AhmeBahaa/Smart-Bionic-Arm-multi-sensor-fusion/Docs/presentationbionic (23-4-2026).pdf

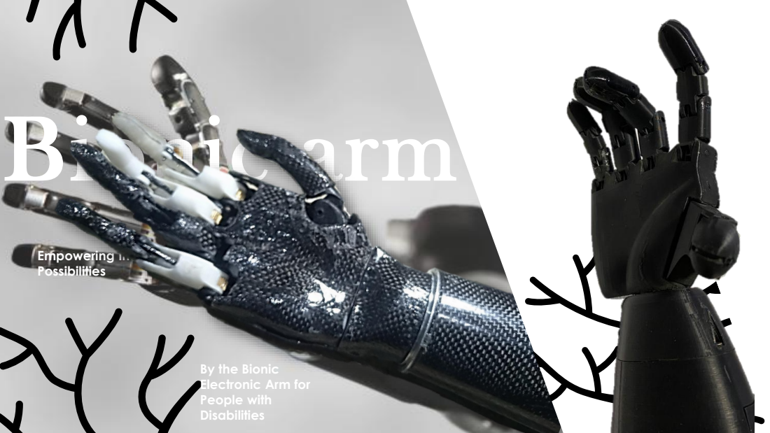
[picture p1: page 1]
Bionic arm

Empowering Individuals with Limitless
Possibilities

By the Bionic
Electronic Arm for
People with
Disabilities

# Problem

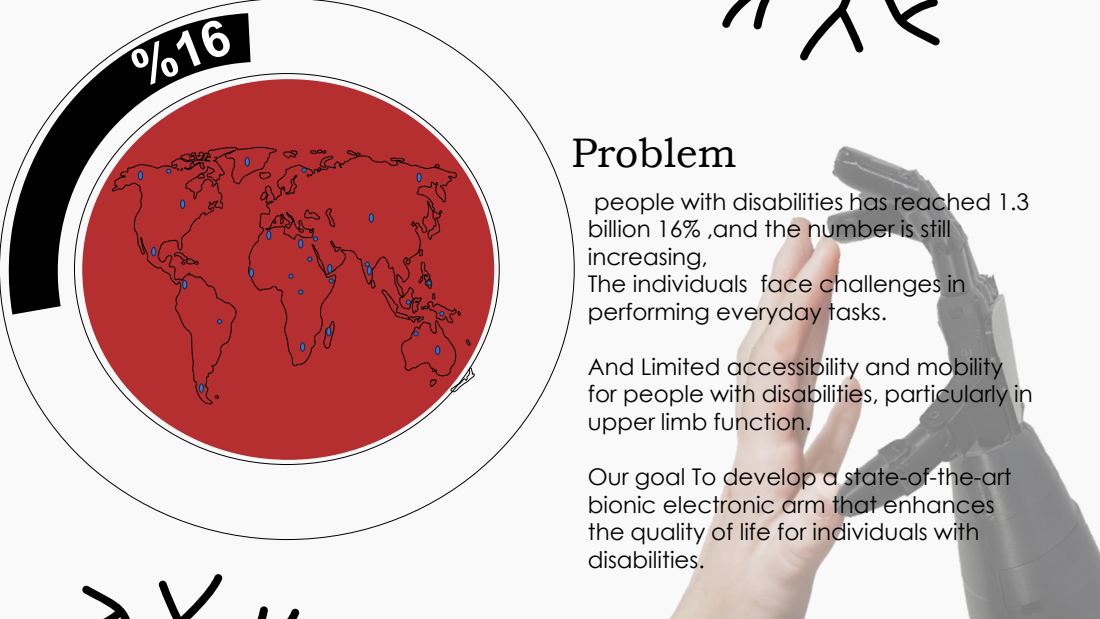
[picture p2: page 2]

people with disabilities has reached 1.3
billion 16% ,and the number is still
increasing,
The individuals face challenges in
performing everyday tasks.

And Limited accessibility and mobility
for people with disabilities, particularly in
upper limb function.

Our goal To develop a state-of-the-art
bionic electronic arm that enhances
the quality of life for individuals with
disabilities.

# BIONIC ARM B

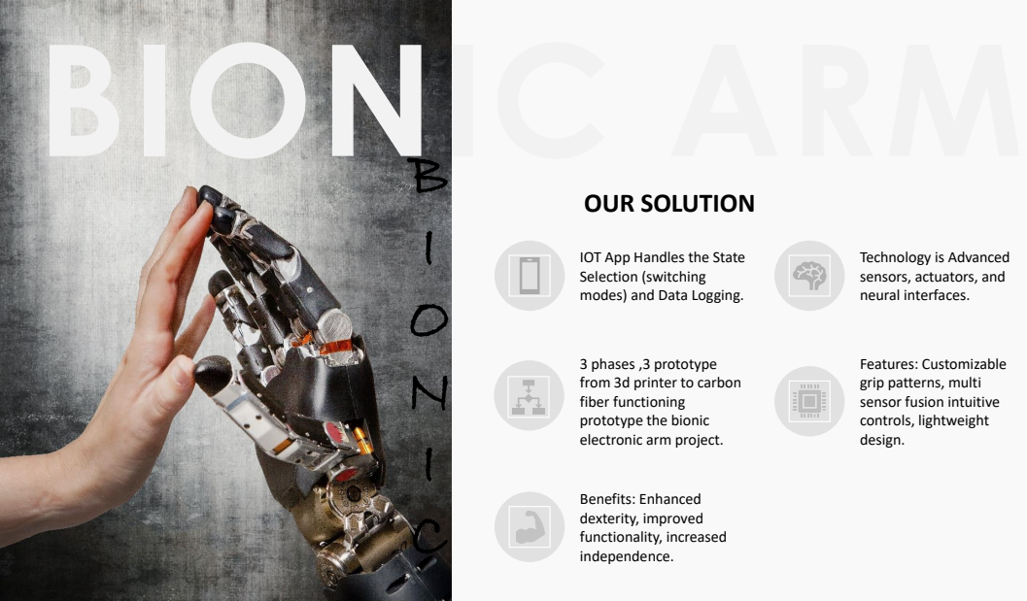
[picture p3: page 3]
Benefits: Enhanced dexterity, improved functionality, increased independence.; OUR SOLUTION

IOT App Handles the State
Selection (switching
modes) and Data Logging.

Technology is Advanced
sensors, actuators, and
neural interfaces.

3 phases ,3 prototype
from 3d printer to carbon
fiber functioning
prototype the bionic
electronic arm project.

Features: Customizable
grip patterns, multi
sensor fusion intuitive
controls, lightweight
design.

3

# rd functional

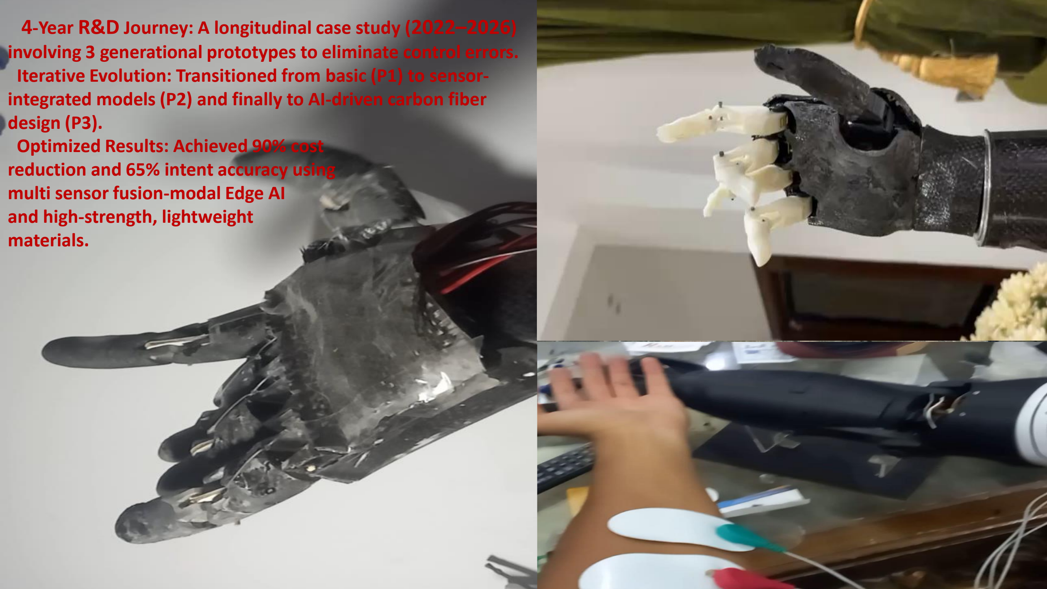
[picture p4: page 4]

# Interesting facts:

# prototype carbon fiber

1

# st ABS 3d printed model

2

nd model | o u r p r o t o t y p e

4-Year R&D Journey: A longitudinal case study (2022–2026) involving 3 generational prototypes to eliminate control errors. Iterative Evolution: Transitioned from basic (P1) to sensorintegrated models (P2) and finally to AI-driven carbon fiber design (P3).
Optimized Results: Achieved 90% cost
reduction and 65% intent accuracy using
multi sensor fusion-modal Edge AI
and high-strength, lightweight materials.

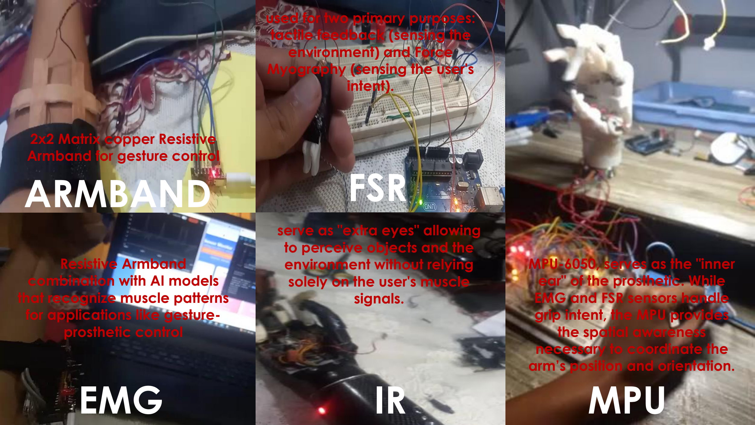
[picture p5: page 5]

# EMG

# FSR

IR | MPU

Resistive Armband
combination with AI models that recognize muscle patterns for applications like gestureprosthetic control

used for two primary purposes: tactile feedback (sensing the environment) and Force
Myography (sensing the user's intent).

serve as "extra eyes" allowing to perceive objects and the environment without relying solely on the user's muscle signals.

MPU-6050, serves as the "inner ear" of the prosthetic. While EMG and FSR sensors handle grip intent, the MPU provides the spatial awareness
necessary to coordinate the arm’s position and orientation.

# ARMBAND

2x2 Matrix copper Resistive Armband for gesture control

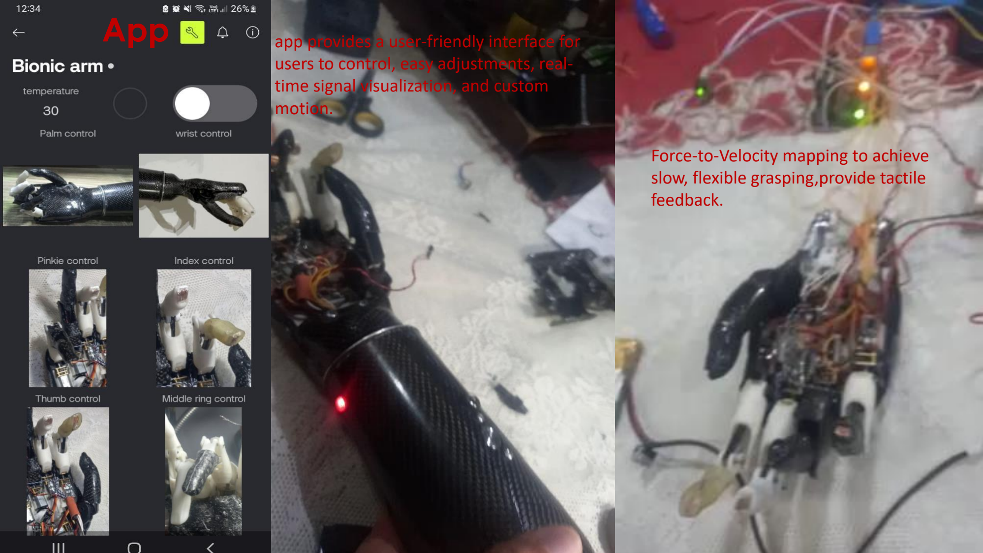
[picture p6: page 6]

# Interesting facts:

App | app provides a user-friendly interface for
| users to control, easy adjustments, real- time signal visualization, and custom motion.

Force-to-Velocity mapping to achieve slow, flexible grasping,provide tactile feedback.

# Weight about 350g

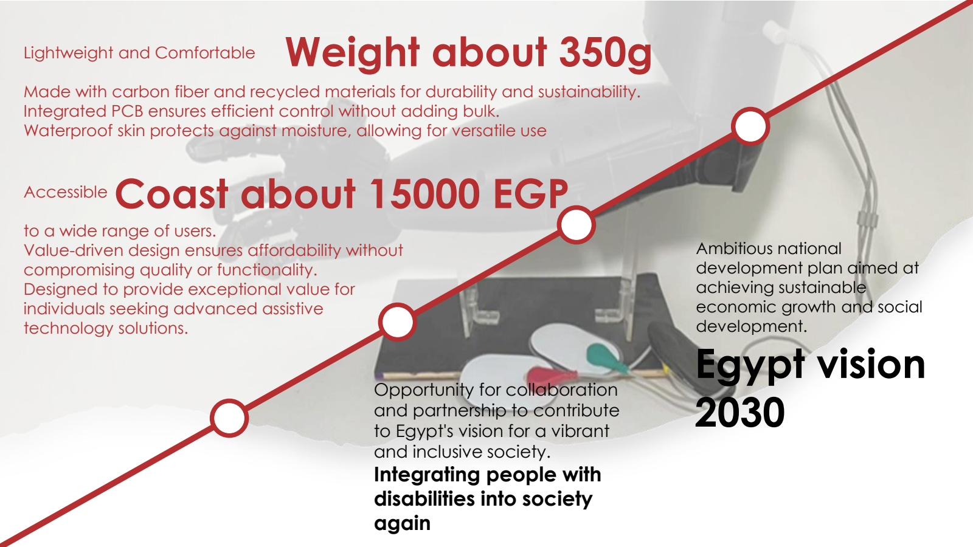
[picture p7: page 7]

# Coast about 15000 EGP

# Egypt vision

2030

### Integrating people with disabilities into society again

Opportunity for collaboration and partnership to contribute to Egypt's vision for a vibrant and inclusive society.

Ambitious national
development plan aimed at
achieving sustainable
economic growth and social development.

Accessible

to a wide range of users.
Value-driven design ensures affordability without compromising quality or functionality.
Designed to provide exceptional value for individuals seeking advanced assistive technology solutions.

Lightweight and Comfortable

Made with carbon fiber and recycled materials for durability and sustainability. Integrated PCB ensures efficient control without adding bulk.
Waterproof skin protects against moisture, allowing for versatile use

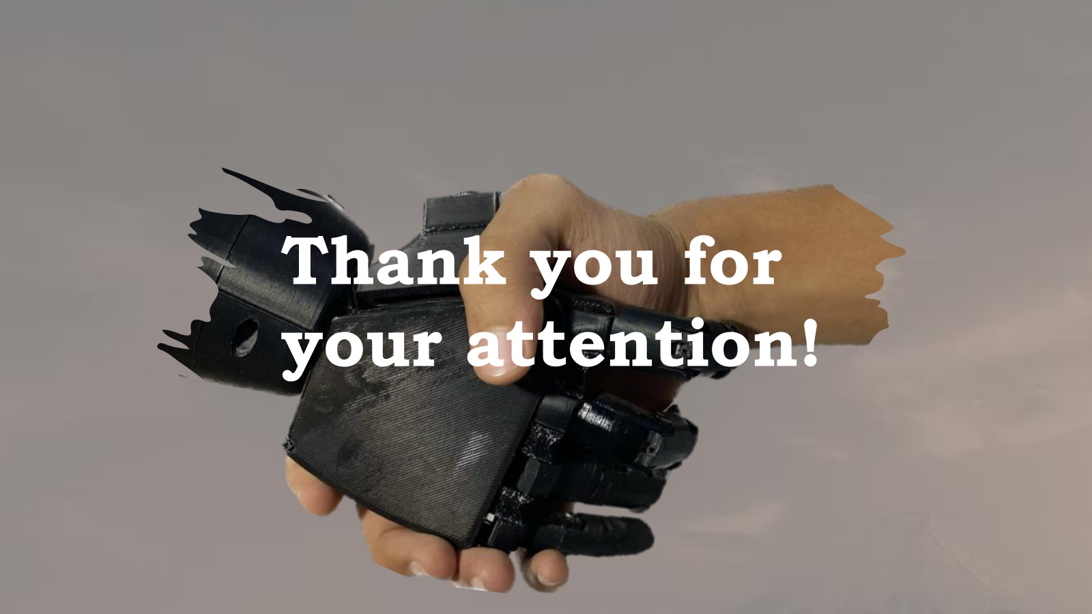
[picture p8: page 8]

# Thank you for your attention!
