AhmeBahaa/Smart-Bionic-Arm-multi-sensor-fusion/Docs/Research not published yet in MJEER-ahmedbahaaproject(10-7-2026 ).pdf

Research not published yet

# Design and Implementation of a Low-cost Carbon Fiber Bionic Arm with Multi-modal Sensor Fusion and IoT-Enabled Adaptive Control

Ahmed Bahaa El-Din, Saad Elsayed Saad

Abstract—Contemporary | prosthetic | arms | are | often
constrained by non-intuitive control mechanisms, excessive weight, and high cost. This paper presents the design and implementation of a low-cost, biomechatronic prosthetic arm utilizing a lightweight carbon fiber frame to achieve a 40% weight reduction (350g) compared to traditional 3D-printed frameworks. To overcome the high noise floor inherent in custom-built surface electromyography (EMG) sensors, a hybrid multimodal sensor fusion framework is introduced. The system implements a deterministic gating logic where a digital moving average filtered EMG signal acts strictly as an asynchronous activation trigger, while an armband pressure matrix tracks muscle expansion to determine specific grasp intents. An ESP32 microcontroller processes the sensory data locally, driving seven independent micro-actuators via an adaptive proportionalintegral-derivative (PID) control loop to ensure smooth, natural object manipulation. An IoT framework enables remote monitoring and clinician-led data logging. The prototype successfully delivers responsive, low-latency actuation under 500ms at an approximate cost of $310 USD.

Keywords— Myoelectric control, Prosthetic manipulation, Multimodal sensing, Embedded rehabilitation systems, Human– machine interface, Assistive robotics.

I. INTRODUCTION
THE Upper limb loss carries profound consequences for independence, since the hand underpins nearly every activity of daily living, and traumatic amputation remains its leading driver. Conventional body-powered and cosmetic prostheses often fail to restore functional dexterity, intuitive control, or meaningful feedback, with studies reporting abandonment rates of 26% for body-powered and 23% for electric devices [4]. While surface electromyography (sEMG) combined with pattern recognition has matured, persistent gaps—such as unintuitive control mappings and fragility under real-world variability—continue to keep most of these advances confined to the laboratory [1], [2], [3].

____________________________________________________________ (Corresponding author: Ahmed Bahaa El-Din).
Ahmed Bahaa El-Din is with the Department of Electronics and Communication Engineering, Higher Institute of Engineering and Technology Al-Obour , PO Box 27, Al Obour City Egypt (e-mail: 221399@oi.edu.eg). Saad Elsayed Saad is with the Department of Electronics and Communication Engineering, Higher Institute of Engineering and Technology Al-Obour, PO Box 27. He is now with the Department of Engineering and Technology, Obour University For Science & Technology, Al-Obour, (e-mail: saad.elsayed@oust.edu.eg(.

Beyond these technical hurdles, the global need for accessible assistive technology is staggering. With over 2.5 billion people requiring at least one assistive product, the World Health Organization and UNICEF (2022) report that access remains severely limited in low- and middle-income countries, with some regions seeing access rates as low as 3% [5]. This trend is mirrored locally in Egypt, where data from the Central Agency for Public Mobilization and Statistics (CAPMAS) indicates a disability prevalence of approximately 11% [6]. These figures underscore a critical socioeconomic gap in the availability of affordable, high-quality, and accessible biomedical solutions.
Addressing these shortfalls requires a convergent design that fuses heterogeneous biosignal and environmental sensing, lightens the mechanical load through composite materials such as carbon-fiber-reinforced laminates, and embeds the device inside a wider IoT service ecosystem for monitoring, recalibration, and personalization [7], [8], [9]. The mechanical architecture of the proposed hand builds upon the open-source compliant prosthetic design of Akhtar et al. [10], originally fabricated from PLA and silicone, extending it through carbon fiber composite construction, wrist rotation via a stepper motor, a six-axis sensor fusion framework (EMG, IMU, IR, FSR, Velostat armband, and temperature), empirical EMG threshold calibration, and an IoT framework comprising a mobile application and clinical web portal. This paper presents a multisensory-controlled bionic upper-limb prosthesis that integrates an accelerometer, infrared sensor, electromyography channel with an AI-driven feature-extraction and classification layer, distributed force-sensitive resistors (including an armband coupled to the EMG electrodes), and temperature sensing within a carbon-fiber, stainless-steel, and polymer hybrid chassis actuated by six DC metal-geared motors and one mini stepper motor for wrist articulation. Intelligence here is confined deliberately to EMG interpretation rather than endto-end autonomous decision making, while a dedicated Internet-of-Things layer—accessible through a mobile application and an accompanying web platform—provides remote monitoring, on-the-fly tuning, news dissemination, and a customization channel for users to commission prostheses fitted to their individual clinical, occupational, and aesthetic needs. By unifying multimodal sensing, robust composite construction, and connected service infrastructure within one platform, the proposed system targets the persistent gap between laboratory-grade myoelectric research and the everyday usability demanded by amputees [9].

II. MATERIALS AND METHODS

A. Mechanical Structure and Material Fabrication The forearm shell, palm plate, and dorsal hand enclosure of the AB-Limb were custom-fabricated from a carbon-fiber-reinforced epoxy laminate, as shown in Fig. 1. Fabrication was executed via Vacuum-Assisted Resin Transfer Molding (VARTM), a process in which a flexible vacuum bag seals a single-sided rigid mold so that atmospheric pressure drives resin through a dry carbon-fiber preform, allowing tight control of the fiber-to-resin ratio and evacuation of internal micro-voids without requiring autoclave pressure [11].

Fig. 1. Final AB-Limb prototype showing the assembled carbon fiber bionic arm alongside raw carbon fiber composite sheets used in fabrication. The hand mold geometry was adapted from the open-source compliant prosthetic design of Akhtar et al. [10], which was originally developed for silicone casting. In this work, the same mold architecture was repurposed for VARTM carbon fiber lamination: woven carbon-fiber plies were dry-laid over each mold, sealed under vacuum bagging film, and infused with a room-temperature-curing epoxy system. The modular component geometries — including wrist shell, palm plate, finger base blocks, and forearm cylinder — were further refined using parametric OpenSCAD scripts to generate gear profiles and mold optimizations prior to casting, as shown in Fig. 2 and Fig. 3.

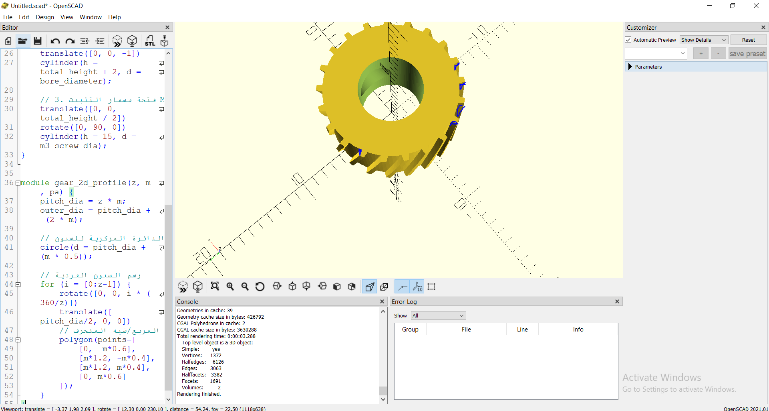
[picture p9: figure]

Fig. 2. Parametric computer-aided design and modular structural gears optimization using OpenSCAD environment.

The resulting composite structure achieved a tensile strength of approximately 600 MPa at a total structural mass of 350 g, representing a 40% weight reduction compared to equivalent aluminum or standard 3D-printed PLA frameworks [12], [13], [14]. This lightweight architecture reduces inertial resistance during movement, enhancing user mobility and reducing fatigue at the residual limb interface. A 1-Degree-of-Freedom wrist rotation unit driven by a miniature stepper motor was integrated along the forearm axis to provide pronation– supination capability absent from earlier single-anchor prosthetic frames [10].

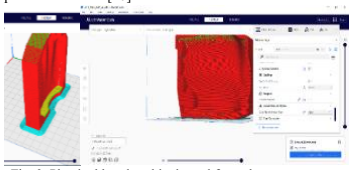
[picture p10: figure]

Fig. 3. Physical hand mold adapted from the open-source design of Akhtar et al. [10], originally developed for silicone casting and modified in this work for VARTM carbon fiber lamination.

B. Actuators and Hybrid Drive Integration Initial prototyping evaluated a direct-drive configuration in which six N20 DC micro-motors were driven through three L293D H-bridge chips cascaded via two cascaded 74HC595 8-bit shift registers were controlled by arduino uno [19],To manage these six channels while minimizing arduino GPIO consumption, as shown in Fig. 4. This architecture reduces the entire six-motor control bus of 4 pins for each motor to a three-wire serial interface — data, clock, and latch — from the microcontroller, electrically isolating the Arduino digital logic rail from inductive kickback during motor stalls .

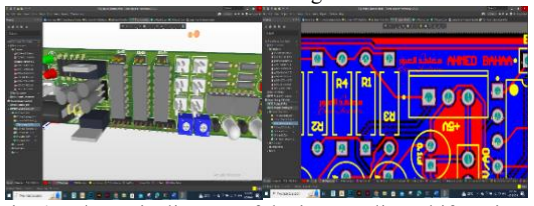
[picture p11: figure]

Fig. 4. Schematic diagram of the intermediate shift register topology interfaced with localized L293D motor drivers. While this arrangement confirmed mechanical feasibility, positional accuracy was insufficient for reliable grasp control and the GPIO demand — even after shift-register demultiplexing — constrained the available pins for the remaining sensor subsystems. These limitations motivated a redesign centered on the ESP32 and a hybrid actuation topology described below.
In the refined system, independent flexion and extension of the five fingers is achieved through six N20-series brushed DC micro-motors with high-ratio metal gearboxes.
Two motors actuate the thumb across two degrees of freedom, while the remaining four drive the index, middle, ring, and little fingers through linkages and custom epoxy-cast gears, as shown in Fig. 2 and Fig. 1.
A seventh channel drives the 1-DOF wrist rotation module via a 5V miniature stepper motor controlled through a ULN2003A driver board [15], [16].
Standard N20 units ship without integral closed-loop position feedback, which typically requires adding bulky optical or magnetic encoders to achieve controlled directional behavior

[16], [17]. To resolve this without inflating the device form factor, the internal control board of an SG90 micro-servo — including its feedback potentiometer and PWM conditioning circuit — was decoupled and integrated directly onto the N20 motor chassis, as illustrated in Fig. 5. The potentiometer is monitored continuously by the ESP32 PWM; when the wiper crosses a predefined directional threshold, a stop pulse is issued and the motor reverses, enabling reliable bidirectional control over each channel independently. This modification eliminates secondary encoders while reducing the per-motor control requirement to a single PWM line, allowing all six fingers to be addressed through only six control signals total.

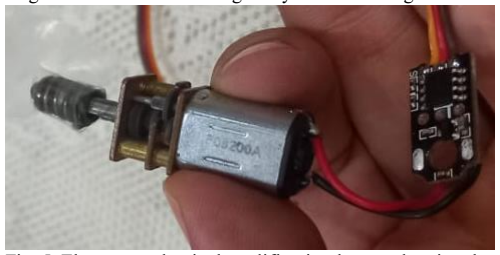
[picture p12: figure]

Fig. 5. Electro-mechanical modification layout showing the integration of decoupled SG90 servo control circuitry onto the N20 chassis.

the PWM commands are generated as hardware-timer pulses on the ESP32 for non-blocking real-time control, and are dynamically scaled by incoming force sensor and IR proximity readings through a local PID loop to suppress oscillation and overshoot during object approach [18].

C. Multi-Modal Sensor Integration and Signal Conditioning
1) Custom Surface Electromyography (EMG) System:
To maintain the cost-effective architecture of the AB-Limb, a custom single-channel active surface EMG (sEMG) acquisition front-end was developed (Fig. 6a), adapting the open-source OpenEMG hardware architecture developed by CharlesLabs as a structural baseline. The physical acquisition layout utilizes two Ag/AgCl surface electrodes with a 2 cm inter-electrode pitch positioned over the belly of the target residual-limb muscle group. A third reference electrode is placed on a nearby bony prominence to suppress common-mode environmental noise.
The differential biopotential is initially fed into a three-opamp instrumentation amplifier front-end built around an LM324 quad operational amplifier (Fig. 6b). This configuration provides a high input impedance (>10 MΩ) to prevent skin-electrode loading artifacts while maximizing the

Common-Mode Rejection Ratio (CMRR) to suppress powerline pickup and motion-induced baseline drift.
To enhance signal conditioning beyond the baseline open-source design, a secondary custom active filtering stage was integrated immediately following the instrumentation amplifier. This stage, engineered utilizing an LM358 dual operational amplifier, implements an active bandpass filter restricting the passband strictly between 20 Hz and 450 Hz. This optimization isolates the canonical sEMG spectral envelope while effectively rejecting low-frequency motion artifacts and high-frequency electronic noise.
The conditioned analog signal is then sampled by the central microcontroller. In firmware, a digital notch filter (50/60 Hz) is executed as an additional guard against grid interference. Following full-wave rectification, the signal is processed via a digital moving-average filter—implemented as a sliding window accumulator over N consecutive ADC samples—to yield a stable, low-latency amplitude envelope suitable as an asynchronous deterministic trigger [1], [2], [3].

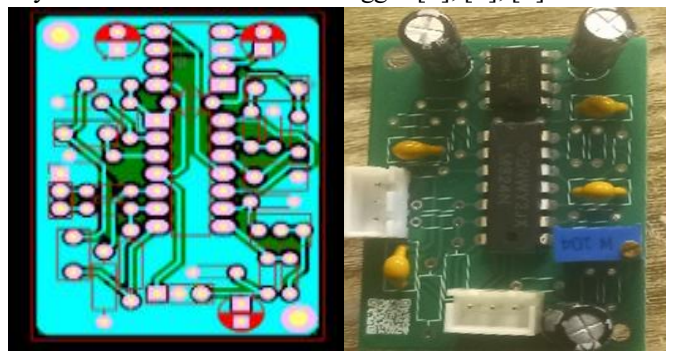
[picture p13: figure]

Fig. 6a. Custom-built active surface EMG sensor PCB layout.

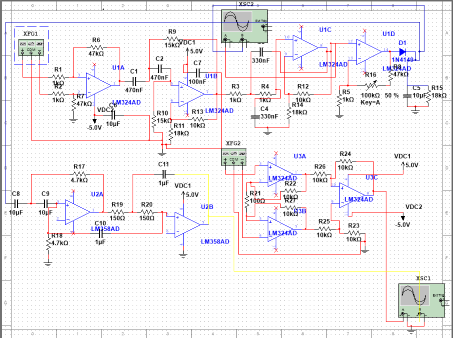
[picture p14: figure]

Fig. 6b. Custom-built active surface EMG sensor schematic hardware showing the LM324 instrumentation amplifier front-end and LM358 bandpass filtering stage.

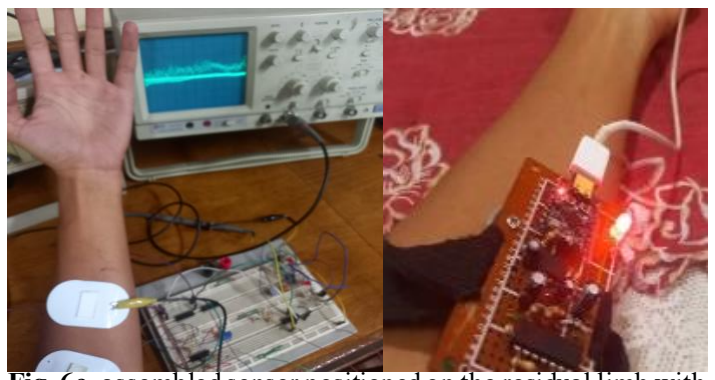
[picture p15: figure]

Fig. 6c. assembled sensor positioned on the residual limb with electrode connections,complete EMG acquisition unit integrated with ESP32-C3 controller for test.

Initial EMG data acquisition sessions revealed three critical calibration challenges that were systematically mitigated. First, a data-labeling anomaly occurred where a spurious third class label ('testing') was inadvertently introduced during token collection, degrading classifier performance to baseline chance level (~50%). This was resolved by filtering the training dataset to enforce strict binary classification (Contracted vs. Relaxed). Second, a structural class imbalance between contraction and relaxation samples was corrected using data resampling techniques to eliminate model bias toward the majority class. Third, an initial digital signal processing (DSP) misconfiguration utilized an improper high-pass filter setting that introduced phase distortion and attenuated critical low-frequency contraction envelopes while passing extraneous high-frequency electronic noise (Fig. 7). This was corrected by optimizing the digital filter coefficients to stabilize the baseline envelope and ensure robust intent recognition.

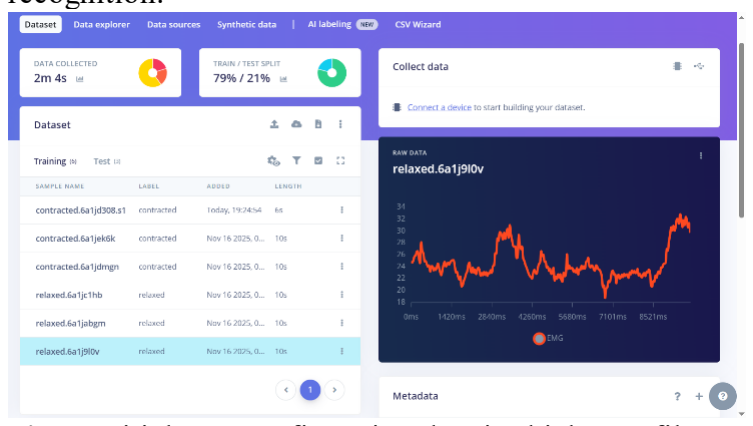
[picture p16: figure]

Fig. 7. Initial DSP configuration showing high-pass filter at 19 Hz cut-off — this setting passed high-frequency noise and produced an unstable filtered output, motivating the filter redesign.
These issues were resolved sequentially: the 'testing' samples were deleted from the dataset, recording sessions were repeated to achieve balanced class durations, and the filter was reconfigured to a low-pass type with a 50 Hz cut-off frequency and FFT length of 512, with StandardScaler normalization enabled. Following these corrections, model training over 30 epochs with a learning rate of 0.0005 achieved 100% classification accuracy with a final loss of 0.00 on both training and validation sets, as confirmed by

TensorBoard convergence curves Fig.8. Fig. 9. The INT8-quantized model deployed on the ESP32 demonstrated an inference latency of 1 ms, a peak RAM consumption of 2.4 KB, and a Flash footprint of 35.8 KB.

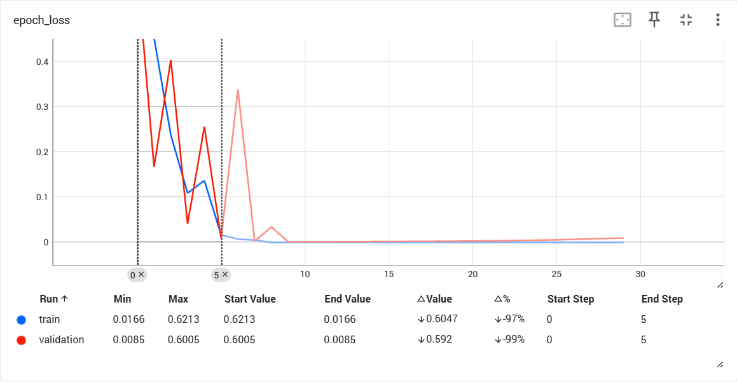
[picture p17: figure]

Fig. 8. TensorBoard epoch loss curves, prior to data cleansing, showing validation loss divergence and 50% accuracy indicative of overfitting.

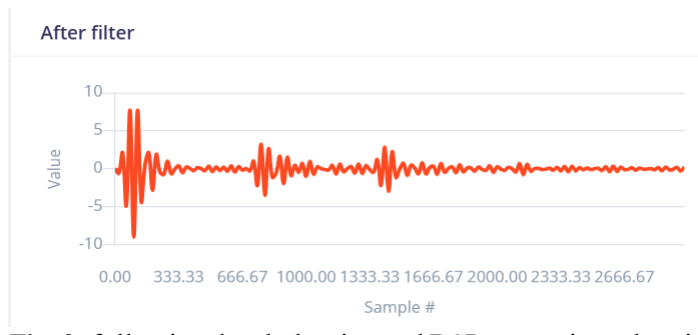
[picture p18: figure]

Fig. 9. following data balancing and DSP correction, showing co-convergence of training and validation loss to 0.00 within 10 epochs, confirming successful generalization.

Subject-specific activation thresholds were determined empirically using the Edge Impulse Studio platform as a signal visualization tool. Raw sEMG signals were captured under two controlled conditions — full voluntary muscle contraction and complete rest — and the resulting amplitude envelopes were inspected to extract the peak activation level and the quiescent baseline, as illustrated in Fig. 10. The activation threshold was iteratively refined through empirical calibration sessions: the subject performed repeated contraction and rest cycles while the threshold constant in firmware was manually adjusted until reliable, false-positive-free triggering was achieved for that individual's signal profile. These empirically determined bounds were encoded as fixed threshold constants in the ESP32 firmware, providing a patient-calibrated binary trigger that avoids the latency and computational overhead of real-time multi-class classifiers.

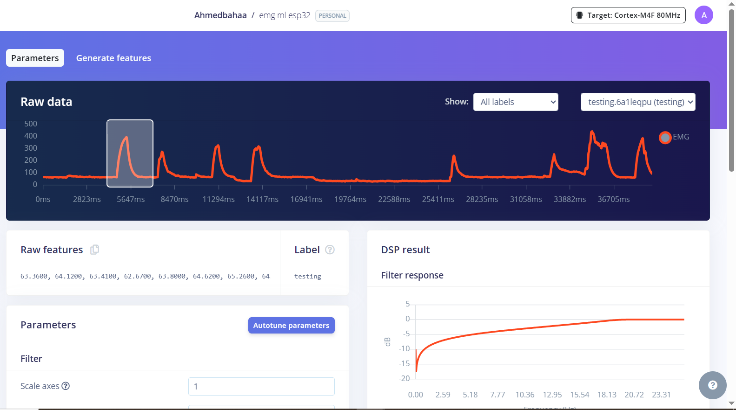
[picture p19: figure]

Fig. 10. Raw sEMG signal acquired via Edge Impulse Studio showing repeated voluntary contraction events (amplitude spikes reaching 0–450 ADC units) interspersed with quiescent rest periods, used to empirically determine the subject-specific activation threshold encoded in ESP32 firmware.
To suppress false-positive triggers arising from EMG drift or motion artifact, actuator activation requires simultaneous confirmation from the 2×2 Velostat armband matrix Fig. 11.

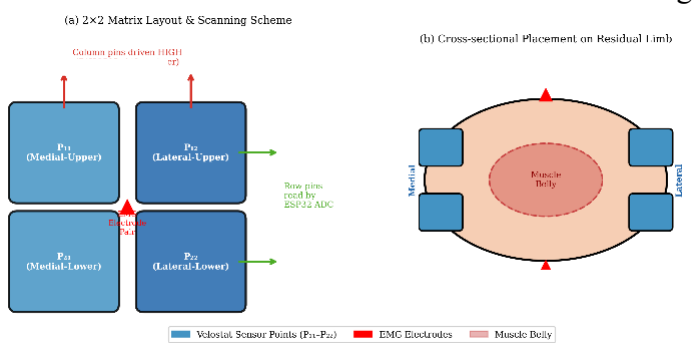
[picture p20: figure]

Fig. 11. Armband pressure matrix showing sensor placement medial and lateral to the primary EMG electrode pair over the muscle belly, and the pulse-scanning readout scheme implemented.

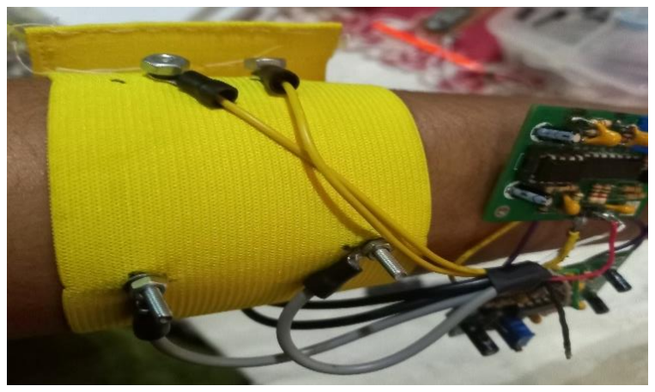
[picture p21: figure]

Fig. 12. layout of the armband and EMG electrode pair over the muscle belly.
the motor command is only issued when both the EMG threshold and at least one armband pressure point are crossed within the same sampling window, implementing a dual-verification logic gate in firmware [22], [23].The four armband sensing points are positioned at two anatomical landmarks: medial and lateral to the primary EMG electrode pair, directly over the muscle belly Fig. 12., so that voluntary contraction produces a consistent bilateral pressure signature.
2) Spatial Armband Pressure Matrix and Custom Force Sensors:
To resolve the false-positive triggering that arises from raw sEMG drift, the AB-Limb integrates a tactile sensing layer with two distinct physical roles: an internal intent validator and an external contact verifier [24]. The internal layer is a custom 2×2 armband pressure matrix fabricated from flexible Velostat sheet, a carbon-loaded polymeric foil whose resistance decreases under pressure, making it a low-cost piezoresistive transducer for wearable sensing [22], [25].

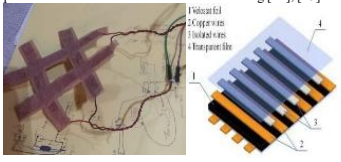
[picture p22: figure]

Fig. 13. Structural layout of the custom Velostat-based spatial armband pressure matrix.

Each column of the matrix was sequentially driven HIGH while the orthogonal rows were read by the ESP32 ADC, implementing a fast pulse-scanning readout that suppresses ghosting during simultaneous multi-point contact. The raw readings were smoothed with a first-order digital low-pass filter with α = 0.08 to yield a stable mechanical image of muscle bulging under voluntary contraction, providing an intent channel independent of the electrical noise floor that limits surface EMG [24], [25], [26].
For external contact verification, four custom force-sensing resistors measuring 6 mm × 6 mm were embedded into the distal phalanges of the prosthetic fingertips Fig. 14. each FSR was wired into a 10 kΩ pull-down voltage divider so that mechanical load maps linearly to an analog voltage readable by the ESP32 ADC [27], [28]. The force reading was passed through a Force-to-Velocity algorithm that progressively reduces drive PWM as grip force increases, preventing brittle objects from being crushed during pinch closure. A localized PWM-driven vibration motor against the user's skin was triggered on contact confirmation to close the sensory loop [29], [30].

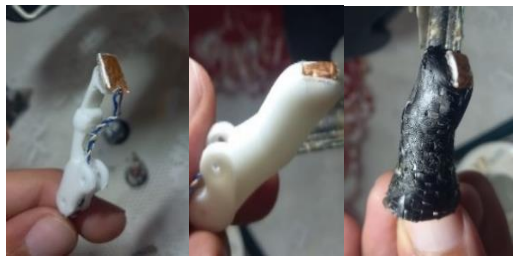
[picture p23: figure]

Fig. 14. Miniaturized 6mm x 6mm custom fingertip force sensor integration and voltage divider conditioning circuit.

3) Kinematic Motion Processing Unit (MPU):
An MPU6050 six-axis inertial measurement unit, combining a tri-axis accelerometer and a tri-axis gyroscope on a single chip, was embedded inside the dorsal hand enclosure to provide orientation-aware control that operates independently of, and complementary to, the sEMG channel [29], [31]. Raw angular data from the gyroscope was fused with accelerometer-derived gravity references through a complementary filter to obtain a stable tilt estimate along the wrist's principal bending axis Fig. 15. When gesture-control mode is selected through the mobile application, the residual-limb tilt is fed through the same PID regulator used for motor commutation: forward tilt drives uniform finger flexion, backward tilt drives uniform extension, and a dead-band around the level orientation locks the actuators in a steady-

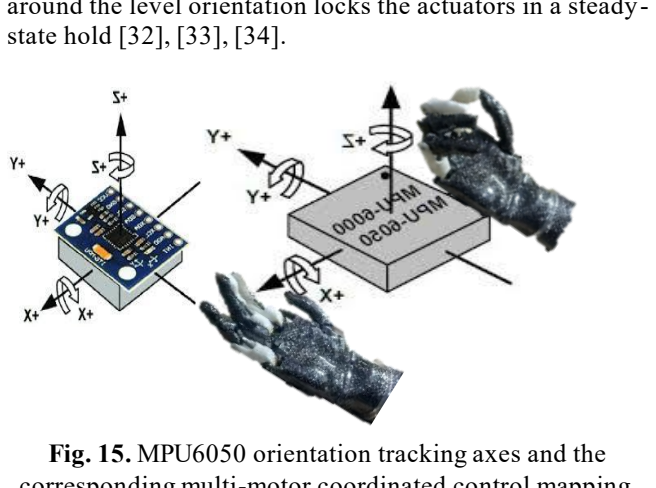
[picture p24: figure]
state hold [32], [33], [34].

Fig. 15. MPU6050 orientation tracking axes and the corresponding multi-motor coordinated control mapping.

4) Infrared (IR) Proximity and Collision Avoidance Gating:
A short-range infrared emitter-photodiode pair mounted on the palmar surface of the prosthesis continuously samples the distance between the terminal device and any approaching object. The photodiode output is conditioned by an LM358-based Fig. 16. comparator that yields a binary trigger as the object enters a pre-set safety envelope, and the smoothed analog channel is fed into the same PID loop that governs motor velocity so that approach speed is scaled inversely with distance, decelerating the actuators near object boundaries [29], [35], [27], [36]. This channel also acts as a hardwareinterrupt-driven reflexive layer: a rapid proximity transition during a hold-and-release state bypasses the main sEMG/IMU threads and fires an emergency close command that mimics a biological protective reflex [30], [37].

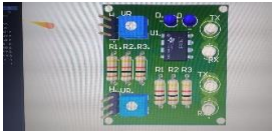
[picture p25: figure]

Fig. 16. PCB layout of the LM358-driven infrared proximity sensing circuit.

5) Thermal Monitoring Layer:
An NTC thermistor with β = 3950 was embedded at the residual-limb interface inside the socket wall, selected over non-contact infrared modules such as the MLX90614 because its small form factor and direct skin contact provide higher accuracy in the clinically relevant 35°C to 42°C range [38], [39], [40]. The thermistor was paired with a 10 kΩ balance resistor to form a voltage divider readable by the ESP32 ADC, and the nonlinear resistance-to-temperature relationship was linearized in firmware using the Steinhart–Hart equation:

where T is the absolute temperature in kelvin, R is the computed thermistor resistance, and A, B, and C are coefficients derived from the manufacturer datasheet (β = 3950). Because the ESP32's successive-approximation ADC exhibits nonlinearity near the 0 V and 3.3 V saturation margins, an oversampling and averaging routine of 10–20 samples per reading was executed to suppress transient electronic noise and stabilize the calibrated output [41], [42]. Thermal readings are streamed to the cloud IoT portal and trigger an alert if the residual-limb skin temperature exceeds the physiologically safe envelope, guarding against the insocket heat accumulation linked to skin irritation and prosthesis abandonment [43], [44].

D. | Control | System | Architecture, | IoT
Infrastructure, and Power Management
1) Central Controller and System Architecture: The core processing hub of the AB-Limb is an ESP32 DevKit microcontroller, chosen for its dual-core 240 MHz architecture, native Wi-Fi and Bluetooth Low Energy radios, and its demonstrated capacity to host real-time sEMG and sensor-fusion pipelines on a low-cost embedded platform [21], [45]. The firmware is organized as a state-triggered actuation engine: grip selection, sensor gating, and actuation windows are exposed as runtime-tunable parameters that the user can adjust through the mobile companion application rather than through low-level firmware reflash, allowing patients to adapt the prosthesis to changing daily-life activities without any code modification [46], [21].

1
T

= A + Bln(R) + C (ln(R))

3

(1)

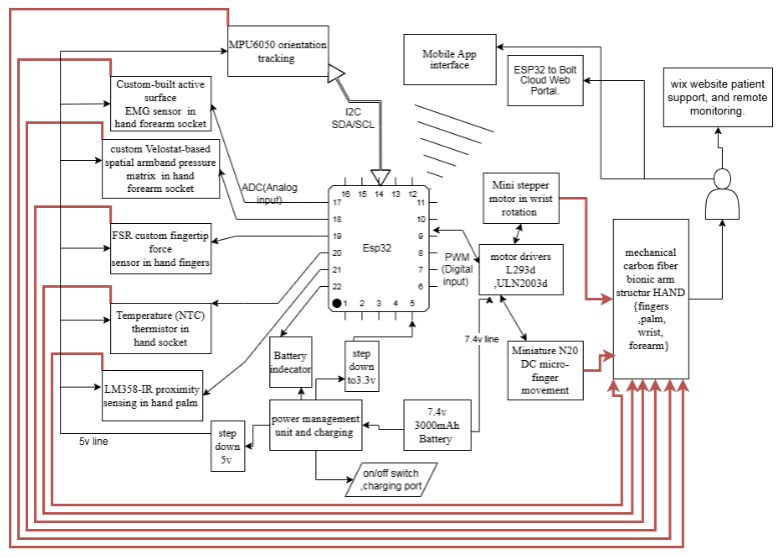
[picture p26: figure]

Fig. 16. System block diagram showing the ESP32 core architecture, multi-sensor interfacing layers, and peripheral distribution.

2) Cloud IoT Telemetry and Remote Clinical Portal:
Filtered sEMG envelopes, force-matrix readings, IMU orientation logs, and thermal samples are encrypted and transmitted over Wi-Fi to a centralized cloud portal built around the Bolt IoT framework, exposing WebSocket, MQTT, and HTTP endpoints that allow clinicians to asynchronously review biomechanical signal histories, track muscle-health progression, and adjust validation thresholds remotely [9], [46], [47], [48]. The same portal hosts a public news and updates channel and a customization intake form through which users can commission prostheses fitted to their individual clinical, occupational, and aesthetic requirements, closing the Industry 4.0 loop between physical actuation and digital service infrastructure [49].Fig. 17.

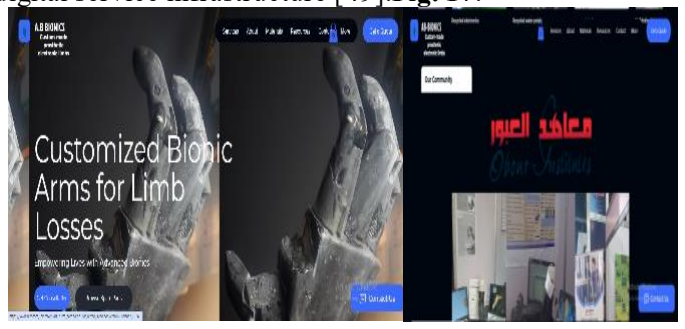
[picture p27: figure]

Fig. 17. Cloud IoT web portal interface showing real-time EMG signal monitoring dashboard, remote clinical threshold adjustment panel, and patient customization intake form.

3) Power Management System:
Mobile operation is sustained by a lightweight 7.4 V two-cell lithium-polymer battery pack with a high discharge C-rating sufficient to absorb the transient inrush currents drawn during simultaneous multi-motor grasping routines. A dual-stage synchronous buck DC-to-DC converter topology supplies a regulated 3.3 V rail for the ESP32 and sensor front-end and a separate high-current rail for the L293D motor drivers, isolating the noise-sensitive digital logic lines from the inductive voltage ripple and stall-current spikes of the brushed

DC actuators during peak load conditions [48], [21].
To extend operational battery life during periods of prosthetic inactivity, the ESP32's native Deep Sleep mode was implemented in firmware. In this state, all peripheral clocks, the Wi-Fi radio, and the main CPU cores are gated off,
reducing the | microcontroller's | current | draw | from
approximately 240 mA during active multi-sensor polling to under 10 μA. A configurable inactivity timer monitors the sEMG envelope and armband pressure channels; if no voluntary activation event is detected within a user-defined timeout window, the system autonomously transitions to Deep Sleep and resumes full operation upon the next muscle contraction trigger via the ULP co-processor wake-up interrupt. This adaptive duty-cycling strategy significantly reduces mean current consumption during daily prosthetic use, where active grasping intervals are interspersed with extended periods of limb rest [48].
Fig. 18.

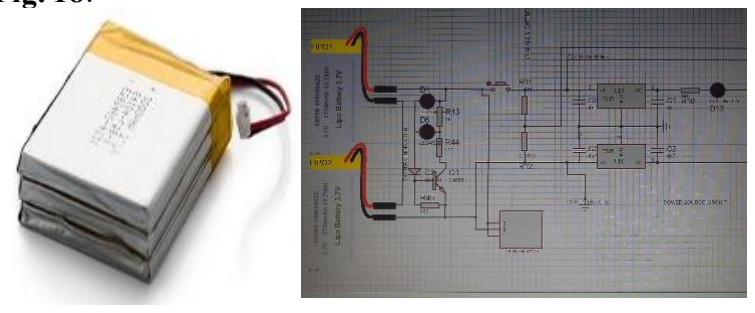
[picture p28: figure]

Fig. 18. Schematic of the power management unit showing the 7.4V LiPo source and dual-stage buck regulation paths for digital and motor power rails.
4) Software Architecture and Multi-Modal Control Topology:
The ESP32 firmware implements a layered multi-modal control pipeline in which four operating modes share a common actuation scheduler [46], [50]:
Mode 1 — Pure EMG Control: evaluates the rectified, smoothed sEMG amplitude directly and maps temporal intensity thresholds to discrete motor actions, providing a fallback channel when the other sensors are unavailable. Mode 2 — Proximity-Triggered IR and Force Regulation: uses the IR proximity channel to pre-shape the optimal grip profile before physical contact occurs, then hands over to the four fingertip FSRs (6 mm × 6 mm each) for compliant force modulation during contact [27], [36].
Mode 3 — Kinematic IMU Orientation Mapping: translates residual-limb tilt into grip configuration through gravity-compensated positioning — forward tilt drives uniform finger flexion, backward tilt drives extension, and a dead-band around level orientation locks the actuators — providing orientation awareness independent of EMG quality [31], [32]. Mode 4 — Asynchronous Sensor Fusion (Primary Mode): combines all channels through a deterministic gating logic in which the moving-average-filtered EMG envelope acts as an asynchronous activation trigger, the Velostat armband pressure matrix disambiguates grasp intent, the MPU6050 contributes kinematic shape selection, and the fingertip FSRs close the loop with a compliant termination command once a stable grip is established [29], [27], [36], [24]. This layered fusion architecture ensures modularity and facilitates rapid integration of emerging sensing modalities [51], [52], [53].

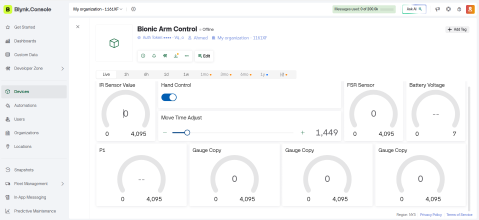
[picture p29: figure]

Fig. 19. Software ecosystem architecture illustrating the real-time data flow between the ESP32, Bolt Cloud library, and cloud web portal.

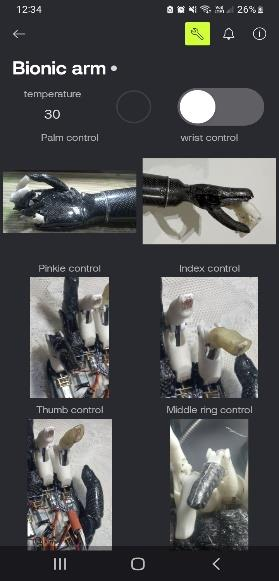
[picture p30: figure]

Fig. 20. Mobile application interface showing grip mode selection, real-time EMG threshold display, and sensor status panel.

III. RESULTS AND DISCUSSION Longitudinal Prototype Evolution Case Study (2022–2026) To achieve the optimized biomechatronic profile of the AB-Limb, a four-year longitudinal development case study was conducted across three distinct generational prototypes, benchmarking structural durability, weight reduction, and sensor reliability at each stage.
Prototype I (Conceptual Phase — 2022): Focused on basic multi-finger kinematics using a fully 3D-printed PLA frame with analog IR sensors. Testing revealed critical limitations in structural strength under load, high inertial mass, and significant electrical noise that precluded reliable EMG signal acquisition.

Prototype II (Sensory Integration Phase — 2024): Transitioned structural framing to reinforced polymers and aluminum alloys. Custom active surface EMG bio-amplifiers and commercial FSRs were introduced. Grip force control was successfully validated; however, structural mass remained high and raw EMG drift produced false-positive actuator triggering, motivating the dual-verification approach adopted in the final design.
Prototype III (Optimized Final Platform — 2026): The structural framework was fully transitioned to VARTMmolded carbon fiber-epoxy composite, integrating the 2×2 Velostat armband scanning matrix, MPU6050 orientation tracking, and autonomous reflex gating logic, as shown in Fig.
21. This iteration achieved a 40% reduction in structural weight relative to Prototype II and a production cost below $310 USD, representing over 90% reduction compared to premium commercial benchmarks.

Fig. 21. Generational evolution chart of the AB-Limb prototypes (2022–2026) mapping structural material transitions against sensor integration complexity.

B. System Actuation and Latency Performance End-to-end system latency — defined as the elapsed time from initial voluntary muscle contraction to completion of terminal device grasp execution — was assessed using repeated timed trials with a mobile stopwatch reference across multiple contraction-and-release cycles. The measured average deployment latency was 380 ms under normal operating conditions, which sits comfortably below the 500 ms perceptual threshold identified in the literature as the boundary for intuitive prosthetic responsiveness [54], [56].
The PID velocity control loop was evaluated by comparing motor transient behavior with and without active PID feedback during repetitive finger flexion cycles. Without PID correction, the N20 motors exhibited visible positional oscillation and overshoot near object boundaries. With PID active, convergence to the target position was smooth and asymptotic, with no observable overshoot, as illustrated in Fig.
22. The PID response curve was generated from firmware timestamp logs processed in MATLAB to reconstruct the motor velocity profile over time [57].

Initial proof-of-conce pt bionic limb utilizing standard PLA 3D-printed chassis. Integrated a single degree-of-freedom (DoF) actuated by servomotors, triggered via analog EMG sensors with raw signal thresholds,controlled by arduino uno.

Gen 1 Prototype (2022)

Transitioned to Carbon Fiber structures to reduce structural weight under load. Upgraded complexity and IR sensor with EMG sensor with filters and a PIC microcontroller actuated by dc motors and singel servo motor for wrist orientation tracking.

Gen 2 Evolution (2024)

Developed a hybrid rigid-flexible assembly for fullhand dexterity. Implemented sensor fusion multiarray resistive force arm band withe inhansed filterd EMG signal by AI and digital filters with fingers force sensor with PID conteol fedback closed loop with MPU6050 for real-time spatial orientation tracking, coupled with an ESP32 Edge AI neural network for real-time gesture recognition and Blynk cloud-based telemetry web and mobile app .

Gen 3 Final Version (2026)

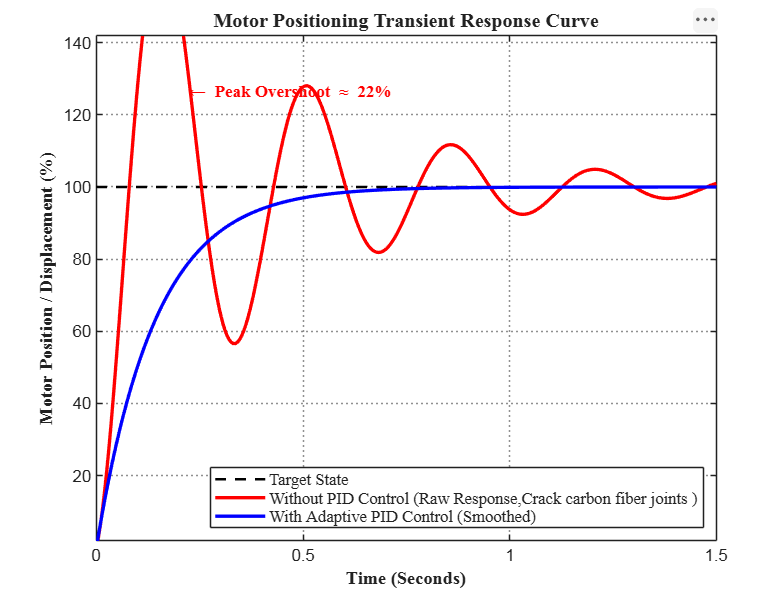
[picture p31: figure]

Fig. 22. Simulated transient response curve illustrating motor positioning behavior with and without PID feedback, generated from firmware timing parameters in MATLAB.

C. Multi-Modal Sensor Validation and Feedback Stability:

The custom LM324-based instrumentation amplifier front-end was evaluated using an oscilloscope during dynamic arm movement. The baseline noise floor was observed to fluctuate during measurement; a representative peak-to-peak noise level of approximately 15 mV was recorded under typical operating conditions, consistent with acceptable surface EMG acquisition noise thresholds reported in the literature [1], [2]. The dual-verification gating logic — requiring simultaneous EMG threshold crossing and armband confirmation — effectively suppressed false-positive actuator triggers during testing.
The 2×2 Velostat armband pulse-scanning method successfully eliminated ghosting artifacts during multi-point simultaneous contact. The custom 6 mm × 6 mm FSR sensors were evaluated by applying manually-varied compressive loads ranging from light fingertip pressure to a 4 kg static weight. The sensors produced a monotonically decreasing resistance-to-load response, and the Force-to-Velocity mapping algorithm successfully modulated motor PWM proportionally — a filled plastic cup was gripped without deformation, while a paper cup was grasped without crushing, demonstrating adaptive compliance under functional load variation. The PWM-driven vibration motor activated reliably upon fingertip FSR contact during all trials; precise latency was not instrumented in this prototype iteration and is reserved for future quantitative evaluation.

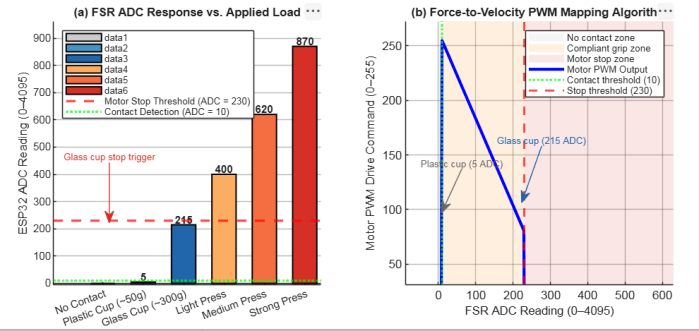
[picture p32: figure]

Fig. 23a. Functional grasping validation: the AB-Limb successfully gripping a filled plastic cup (left) and a paper cup (right) without deformation, demonstrating adaptive Force-to-Velocity compliance.

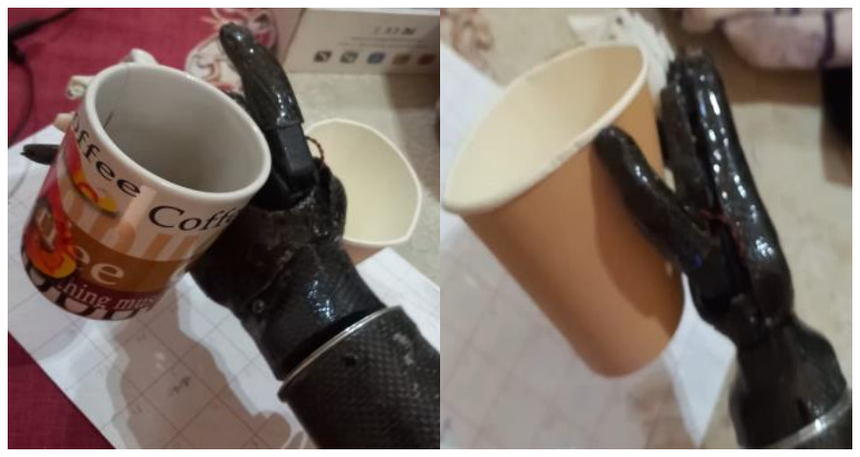
[picture p33: figure]

Fig. 23b. FSR characterization and Force-to-Velocity algorithm validation: (a) measured ESP32 ADC responses across representative applied loads — a plastic cup produced 3–7 ADC units, a glass cup produced 200–230 ADC units, and direct finger compression yielded 400–900 ADC units; (b) the corresponding Force-to-Velocity PWM mapping showing progressive motor deceleration from full drive to complete stop as grip force increases, with the motor halt threshold set at ADC = 230 to prevent object deformation.

D. Socioeconomic Cost Analysis and Weight Optimization:

A core design objective of the AB-Limb is substantial cost reduction without compromising biomechatronic functionality. All component purchases were tracked through itemized invoices totaling approximately 15,000 EGP (~$310 USD at current exchange rates), providing an auditable cost basis for the prototype. Advanced commercial myoelectric hands such as the BeBionic (Otto Bock) and I-Limb (Össur) are priced at approximately €28,000, while the Vincent Hand reaches $44,500, placing them beyond the economic reach of the majority of prosthetic users in low- and middle-income countries [4], [58]. In line with WHO prosthetics and orthotics provision guidelines [5], the AB-Limb targets this critical affordability gap.
Table I presents a comprehensive technical and economic benchmark comparing the AB-Limb against three premium commercial alternatives and the open-source compliant hand by Akhtar et al. [10].

TABLE I
Socioeconomic and Structural Comparison of Upper-Limb Prosthetics
Technical Specificat ions | Be Bionic [4] | I-Limb [4], [8] | Vincent Hand [4] | Open-Source Complian t Hand [10] | Proposed AB-Limb
Manufact uring Company | Otto Bock | ÖSSUR | Vincent Systems | A. Akhtar et al. (UIUC) | A.B. Labs
Approxi mate Cost | €28,000 | €28,000 | $44,500 | $553.06 USD | ~$310 USD (15,000 EGP)
Total System Weight (g) | 500g | 599g | 410g | ~425g (Hand Only) | 350g
Operatin g Voltage (V) | 7.4V | 7.4V | 6.0V – 8.0V | 7.4V | 7.4V
Battery Chemistr y | Li-ion | Li-Po | Li-Po | Li-Po | Li-Po
Battery Capacity (mAh) | 1300 – 2200 | 1300 – 2400 | 1300 – 2600 | 1500 | 1500 – 3000
Total Actuator Count | 5 | 6 | 6 | 5 | 7
Actuator Drive Type | DC Motor + Lead Screw | DC Motor + Worm Gear | DC Motor + Worm Gear | Mini DC Worm Gear | Mini DC Worm Gear & Stepper
Active Digit Count | 5 | 5 | 5 | 5 | 5
Grip Force Range (N) | 140 N | 100 N | 60 N | _ | 51 N – 132 N
Control Modalitie s | EMG | EMG, Gesture, Mobile App | EMG | Commerci al EMG, Force | EMG, IR, IMU, Force Matrix, App, Web

As shown in Table I, the AB-Limb achieves a disruptive price point of ~$310 USD, representing a 90% cost reduction relative to commercial alternatives [4]. At 350 g, it is the lightest design in the comparison, with seven independent actuators exceeding all compared systems. Control versatility spans six input modalities (EMG, IR, IMU, Force Matrix, App, and Web), compared to the single or dual modalities of commercial alternatives.

E. Layered Control Architecture and Smart Gating Validation:
The embedded control hierarchy was validated across three functional real-time operational layers through structured physical testing, as illustrated in Fig. 24.
1) Reflexive Layer: The palm-mounted IR proximity sensor was calibrated via a trimmable potentiometer integrated into the circuit, set to trigger at approximately 3 cm object distance to suppress spurious background reflections. Functional validation confirmed that placing the hand near an object during a hold state reliably triggered an emergency close command through the hardware interrupt path, bypassing the main EMG processing thread and mimicking a biological protective reflex response.
2) Precision Layer: Fingertip FSR force feedback was validated using two representative test objects: a filled plastic cup and an empty paper cup. The Force-to-Velocity algorithm successfully modulated motor drive current in both cases — maintaining a stable grip on the filled cup without slippage and preventing structural deformation of the paper cup. These results confirm that the closed-loop proportional force feedback layer provides effective adaptive compliance across a functionally relevant load range [60], [59].
3) Stabilization Layer: The IMU-based leveling mode was validated in a structured cup-retention task. The prosthetic hand was commanded to grip a water cup placed on a flat surface with finger actuators locked in the closed position. The forearm assembly was then tilted laterally left and right — the wrist stepper motor compensated in the opposite direction to maintain the cup's vertical orientation. The forearm was subsequently tilted forward, causing the fingers to open and lower toward the cup surface; upon lowering the wrist, the fingers closed and successfully re-grasped the cup. This trial confirmed that the MPU6050-driven gravity-compensated positioning delivers functional object stabilization independent of EMG input [5], [48], [49].

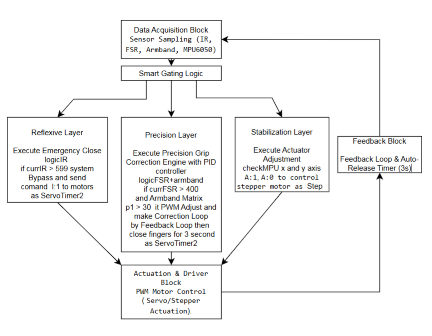
[picture p34: figure]

Fig. 24. System control flowchart illustrating the interaction between the Reflexive, Precision, and Stabilization layers.

IV. CONCLUSION
This paper presented the design, structural optimization, and multi-modal control architecture of the AB-Limb, a low-cost, high-functionality upper-limb bionic prosthesis. By leveraging a custom-fabricated carbon fiber-epoxy composite framework via VARTM, the complete forearm and hand assembly achieved a structural mass of 350 g — a 40% reduction relative to conventional aluminum or 3D-printed PLA equivalents. A deterministic hybrid control pipeline on the ESP32 microcontroller eliminated classification latencies, achieving a measured end-to-end deployment response time of 380 ms, well within the 500 ms intuitive control threshold.

Economically, the substitution of premium commercial
modules | with | custom-engineered | EMG electronics,
miniaturized Velostat sensor configurations, and open-source mechanical components constrained the total production cost to approximately $310 USD (15,000 EGP), validated by itemized purchase invoices. Future work will focus on instrumented quantification of vibration feedback latency, formal clinical evaluation with prosthetic users, integration of continuous glucose monitoring sensors within the socket interface, and deployment of edge-AI regression algorithms for proportional myoelectric velocity control directly on the ESP32.

ACKNOWLEDGMENT
This work was supported by the Higher Institute of Engineering and Technology, Al-Obour, under the administrative guidance of Eng. Walid El-Dahan, Secretary-General of Al-Obour Institutes. The authors express their sincere gratitude to Dr. Saad Elsayed Saad for his invaluable academic supervision, technical guidance, and sustained research mentorship throughout the execution of this biomechatronic framework.

REFERENCES

[1] M. A. Oskoei and H. Hu, "Myoelectric control systems—A survey," Biomedical Signal Processing and Control, vol. 2, no. 4, pp. 275–294, 2007.
[2] W. Abdelrazik, H. Ibrahim, A. El-Bialy, and B. Hemade, "Advancements in Electromyography (EMG) Signal Processing and Classification Techniques for Prosthetic Hand Control Applications: A Comprehensive Review," Industrial Technology Journal, vol. 3, no. 1, pp. 59–87, 2025.
[3] G. F. Deak, F. Rusu, and E. Grosu, "Surface electromyography in biomechanics: Applications and signal analysis aspects," Journal of Physical Education and Sport, vol. 25, no. 4, pp. 12–21, 2009.
[4] J. T. Belter, J. L. Segil, A. M. Dollar, and R. F. Weir, "Mechanical design and performance specifications of anthropomorphic prosthetic hands: A review," Journal of Rehabilitation Research and Development, vol. 50, no. 5, pp. 599–618, 2013.
[5] World Health Organization and UNICEF, Global Report on Assistive
Technology, | 2022. | [Online]. | Available:
https://www.who.int/publications/i/item/9789240049451
[6] Central Agency for Public Mobilization and Statistics (CAPMAS), National Survey on Persons with Disabilities in Egypt 2022, Cairo, Egypt: CAPMAS, 2023. [Online]. Available: https://www.capmas.gov.eg/
[7] D.-A. Türk, H. Einarsson, C. Lecomte, and M. Meboldt, "Design and manufacturing of high-performance prostheses with additive manufacturing and fiber-reinforced polymers," Production Engineering, vol. 12, no. 2, pp. 203–213, 2018, doi: 10.1007/s11740-018-0799-y.
[8] E. A. Abbod et al., "Innovative carbon fiber-reinforced polypropylene for enhanced manufacturing of lower-limb prosthetic sockets," Annales de Chimie
- Science des Matériaux, vol. 49, no. 2, pp. 139-144, 2025.
[9] H. Wu, M. Dyson, and K. Nazarpour, "Internet of Things for beyond-thelaboratory prosthetics research," Philosophical Transactions of the Royal

Society A, vol. 380, no. 2228, 2022, Art. no. 20210005, doi: 10.1098/rsta.2021.0005.

[10] M. F. Akhtar, M. Siddiqui, R. Siddiqi, and S. Qamar, "A low-cost, open-source, compliant hand for enabling sensorimotor control for individuals with transradial amputations," in Proc. 38th IEEE Eng. Med. Biol. Conf. (EMBC), Orlando, FL, USA, 2016, pp. 4642–4645, doi: 10.1109/EMBC.2016.7591762.
[11] R. Elgamsy, M. I. Awad, N. Ramadan, A. Amer, Y. Osama, R. El-Hilaly, and A. Elsabbagh, "Localization of composite prosthetic feet: Manufacturing processes and production guidelines," Sci. Rep., vol. 13, Art. no. 17421, Oct. 2023, doi: 10.1038/s41598-023-44008-7.
[12] E. A. Abbod, S. H. Challoob, K. K. Resan, A. A. Salman, M. A. Abdulrehman, and A. K. Muhammad, "Innovative carbon fiber-reinforced polypropylene for enhanced manufacturing of lower-limb prosthetic sockets," Annales de Chimie - Science des Matériaux, vol. 49, no. 2, pp. 139–144, 2025, doi: 10.18280/acsm.490204.
[13] M. K. Owen and J. D. DesJardins, "Transtibial prosthetic socket strength: The use of ISO 10328 in the comparison of standard and 3D-printed sockets,"
J. Prosthetics Orthotics, vol. 32, no. 2, pp. 93–100, Apr. 2020, doi: 10.1097/JPO.0000000000000306.
[14] M. J. Gerschutz, M. L. Haynes, D. M. Nixon, and J. M. Colvin, "Tensile strength and impact resistance properties of materials used in prosthetic check sockets, copolymer sockets, and definitive laminated sockets," J. Rehabil. Res. Dev., vol. 48, no. 8, pp. 987–1004, 2011, doi: 10.1682/JRRD.2010.10.0204.
[15] C. Cipriani, M. Controzzi, and M. C. Carrozza, "The SmartHand transradial prosthesis," J. Neuroeng. Rehabil., vol. 8, Art. no. 29, 2011, doi: 10.1186/1743-0003-8-29.
[16] V. Abarca, G. Oshiro, O. A. Gonzales-Huisa, and D. Elias, "Design exploration and kinematic validation of a transtibial prosthesis using a 2SPU-RU parallel mechanism," Intelligent Service Robotics, vol. 18, pp. 1315– 1337, 2025, doi: 10.1007/s11370-025-00646-6.
[17] F. M. Mughal and A. M. Mughal, "Modeling and analysis of design parameters selection for biomechanical movement of prosthetic finger," in Proc. 25th Int. Multitopic Conf. (INMIC), Lahore, Pakistan, 2023, pp. 1–6, doi: 10.1109/INMIC60434.2023.10466112.
[18] J. Hamdi, S. Munshi, S. Azam, and A. Omer, "Development of a master– slave 3D printed robotic surgical finger with haptic feedback," J. Robot. Surg., vol. 18, Art. no. 168, 2024, doi: 10.1007/s11701-024-01819-8.
[19] Texas Instruments, 74HC595 8-Bit Shift Registers With 3-State Output Registers, Datasheet No. SCLS041I, Dallas, TX, USA: Texas Instruments, 2022. [Online]. Available: https://www.ti.com/lit/ds/symlink/74hc595.pdf
[20] M. B. I. Reaz, M. S. Hussain, and F. Mohd-Yasin, "Techniques of EMG signal analysis: Detection, processing, classification and applications," Biol. Procedures Online, vol. 8, no. 1, pp. 11–35, 2006, doi: 10.1251/bpo115.
[21] S. E. Francis, M. F. Hussain, and C. M., "Intelligent prosthetic limb actuation using EMG sensors for neuromuscular rehabilitation in amputees," in Proc. 2026 Int. Conf. Intell. Innovative Technol. Comput. Electr. Electron.
(IITCEE), | Bangalore, | India, | 2026, | pp. | 1–6, | doi:
10.1109/IITCEE67948.2026.11394561.
[22] K. K. Pulluri, V. N. Kumar, K. Bagadi, V. Annepu, and F. Benedetto, "Development of wireless smart sleeve using pressure sensitive resistor,"
IEEE | Access, | vol. | 11, | pp. | 135166–135174, | 2023, | doi:
10.1109/ACCESS.2023.3338373.
[23] H. Zhou, C. Tawk, and G. Alici, "A multipurpose human–machine interface via 3D-printed pressure-based force myography," IEEE Trans. Ind.
Inform., | vol. | 20, | no. | 6, | pp. | 8838–8849, | Jun. | 2024, | doi:
10.1109/TII.2024.3375376.

[24] E. Cho, R. Chen, L.-K. Merhi, Z. Xiao, B. Pousett, and C. Menon, "Force myography to control robotic upper extremity prostheses: A feasibility study,"
Front. | Bioeng. | Biotechnol., | vol. | 4, | Art. | no. | 18, | 2016, | doi:
10.3389/fbioe.2016.00018.
[25] D. Esposito, E. Andreozzi, G. D. Gargiulo, A. Fratini, G. D'Addio, G. R. Naik, and P. Bifulco, "A piezoresistive array armband with reduced number of sensors for hand gesture recognition," Front. Neurorobot., vol. 13, Art. no. 114, 2020, doi: 10.3389/fnbot.2019.00114.
[26] R. Kõiva, E. Riedenklau, C. Viegas, and C. Castellini, "Shape conformable high spatial resolution tactile bracelet for detecting hand and wrist activity," in Proc. IEEE Int. Conf. Rehabil. Robot. (ICORR), Singapore, 2015, pp. 157–162, doi: 10.1109/ICORR.2015.7281192.
[27] S. Cofer, T. N. Chen, J. J. Yang, and S. Follmer, "Detecting touch and grasp gestures using a wrist-worn optical and inertial sensing network," IEEE Robot. Autom. Lett., vol. 7, no. 4, pp. 10842–10849, Oct. 2022, doi: 10.1109/LRA.2022.3191173.
[28] J. Konstantinova, A. Stilli, and K. Althoefer, "Force and proximity fingertip sensor to enhance grasping perception," in Proc. IEEE/RSJ Int. Conf. Intell. Robots Syst. (IROS), Hamburg, Germany, 2015, pp. 3105–3110, doi: 10.1109/IROS.2015.7353659.
[29] A. Krasoulis, I. Kyranou, M. S. Erden, K. Nazarpour, and S. Vijayakumar, "Improved prosthetic hand control with concurrent use of myoelectric and inertial measurements," J. Neuroeng. Rehabil., vol. 14, Art. no. 71, 2017, doi: 10.1186/s12984-017-0284-4.
[30] A. L. Ciancio et al., "Control of prosthetic hands via the peripheral nervous system," Front. Neurosci., vol. 10, Art. no. 116, 2016, doi: 10.3389/fnins.2016.00116.
[31] N. Ghaffar Nia, E. Kaplanoglu, A. Nasab, and G. Akgun, "Enhancing prosthetic hand control: A study on IMU sensor-based machine learning for precise hand orientation classification," in Proc. SoutheastCon 2024, Atlanta,
GA, | USA, | 2024, | pp. | 668–674, | doi:
10.1109/SoutheastCon52093.2024.10500296.
[32] J. W. Cui, Z. G. Li, H. Du, B. Y. Yan, and P. D. Lu, "Recognition of upper limb action intention based on IMU," Sensors, vol. 22, no. 5, Art. no. 1954, Mar. 2022, doi: 10.3390/s22051954.
[33] C. Uyanik, S. F. Hussaini, E. Erdemir, E. Kaplanoglu, and A. Sekmen, "A deep learning approach for final grasping state determination from motion trajectory of a prosthetic hand," Procedia Comput. Sci., vol. 158, pp. 19–26, 2019, doi: 10.1016/j.procs.2019.09.023.
[34] A. A. Gambo et al., "An end-to-end wearable device and system for indefinite, continuous, real-time gesture recognition of directional and shapebased arm gestures," IEEE Access, vol. 13, pp. 153436–153463, 2025, doi: 10.1109/ACCESS.2025.3602871.
[35] L. Yu, H. Abuella, M. Z. Islam, J. O'Hara, C. Crick, and S. Ekin, "Gesture recognition using reflected visible and infrared light wave signals," arXiv:2007.08178, 2020.
[36] A. T. Maereg, Y. Lou, E. Secco, and R. King, "Hand gesture recognition based on near-infrared sensing wristband," in Proc. 16th Int. Conf. Informatics Control Autom. Robot. (ICINCO), 2019, pp. 110–117, doi: 10.5220/0008909401100117.
[37] A. Tura, C. Lamberti, A. Davalli, and R. Sacchetti, "Experimental development of a sensory control system for an upper limb myoelectric prosthesis with cosmetic covering," J. Rehabil. Res. Dev., vol. 35, no. 1, pp. 14–26, 1998.
[38] Q. Hua et al., "Skin-inspired highly stretchable and conformable matrix networks for multifunctional sensing," Nat. Commun., vol. 9, Art. no. 244, 2018, doi: 10.1038/s41467-017-02685-9.
[39] E. Stefanelli, M. Sperduti, F. Cordella, N. L. Tagliamonte, and L. Zollo, "Performance assessment of thermal sensors for hand prostheses," IEEE Sensors J., vol. 24, no. 17, pp. 27559–27569, Sept. 2024, doi: 10.1109/JSEN.2024.3431274.
[40] V. Sridhar, "A multimodally-sensing digitally-embedded smart skin for prosthetic hands to restore sensory feedback for amputees," in Proc. IEEE MIT Undergraduate Res. Technol. Conf. (URTC), Cambridge, MA, USA, 2022, pp. 1–5, doi: 10.1109/URTC56832.2022.10002232.
[41] J. Peery, W. Ledoux, and G. Klute, "Residual-limb skin temperature in transtibial sockets," J. Rehabil. Res. Dev., vol. 42, no. 2, pp. 147–154, 2005, doi: 10.1682/JRRD.2004.01.0013.
[42] J. Kwak et al., "Wireless sensors for continuous, multimodal measurements at the skin interface with lower limb prostheses," Sci. Transl.
Med., | vol. | 12, | no. | 574, | Art. | no. | eabc4327, | 2020, | doi:
10.1126/scitranslmed.abc4327.
[43] K. Ghoseiri, Y. Zheng, A. Leung, M. Rahgozar, G. Aminian, T. Lee, and
R. Safari, "Temperature measurement and control system for transtibial prostheses: Functional evaluation," Assistive Technol., vol. 30, no. 1, pp. 30– 37, 2016, doi: 10.1080/10400435.2016.1225850.
[44] N. Mathur, I. Glesk, and A. Buis, "Skin temperature prediction in lower limb prostheses," IEEE J. Biomed. Health Inform., vol. 20, no. 1, pp. 158– 165, Jan. 2016, doi: 10.1109/JBHI.2014.2368774.

[45]F. Kent, A. Putri, Y. Mariana, I. Mahardika, C. Harito, G. K. Andhini, and
C. C. L. Tobing, "Adaptive myoelectric hand prosthesis using sEMG–SVM classification," Prosthesis, vol. 8, no. 1, Art. no. 9, 2026, doi: 10.3390/prosthesis8010009.
[46] C. Williams et al., "Mobile-enabled prosthetic system with machine learning support," in Proc. 2024 IEEE Int. Conf. E-health Netw. Appl.
Services | (HealthCom), | Nara, | Japan, | 2024, | pp. | 1–5, | doi:
10.1109/HealthCom60970.2024.10880762.
[47] N. D. Rajendran, M. E. Prinson, S. Santhosh, and N. Arun, "IoT-enabled prosthetic limb with cloud-based sensory feedback and movement prediction," in Proc. 9th Int. Conf. Electron. Commun. Aerosp. Technol. (ICECA),
Coimbatore, | India, | 2025, | pp. | 554–562, | doi:
10.1109/ICECA66444.2025.11383087.
[48] N. D. R., M. E. Prinson, S. S., and N. A., "IoT-enabled prosthetic limb with cloud-based sensory feedback and movement prediction," in Proc. 9th Int. Conf. Electron. Commun. Aerosp. Technol. (ICECA), Coimbatore, India, 2025, pp. 554–562, doi: 10.1109/ICECA66444.2025.11383087.
[49] L. Frossard, S. Conforto, and O. C. Aszmann, "Editorial: Bionic limb prostheses: Advances in clinical and prosthetic care," Front. Rehabil. Sci., vol. 3, Art. no. 950481, Aug. 2022, doi: 10.3389/fresc.2022.950481.
[50] E. Gasparini et al., "LimbMATE: A versatile platform for closed-loop research in prosthetics," IEEE Trans. Neural Syst. Rehabil. Eng., vol. 33, pp. 2112–2122, 2025, doi: 10.1109/TNSRE.2025.3573917.
[51] S. Mick, C. Marchand, É. de Montalivet et al., "Smart ArM: A customizable and versatile robotic arm prosthesis platform for Cybathlon and research," J. Neuroeng. Rehabil., vol. 21, Art. no. 136, 2024, doi: 10.1186/s12984-024-01423-9.
[52] S. Zhang, H. Zhou, R. Tchantchane, and G. Alici, "Evaluating dual-path temporal fusion strategies for multi-modal hand gesture recognition under limb-position variability," J. Neural Eng., vol. 23, 2026, doi: 10.1088/1741-2552/ae4653.

[53] H. Braun, M. Sierotowicz, F. Egle, M.-A. Scheidl, S. Miranda Montenegro, S. Thuerauf, and C. Castellini, "Introducing MOSAIC: A modular, open-source suite for assistive intelligent control," IEEE Access, vol. 13, pp. 213713–213733, 2025, doi: 10.1109/ACCESS.2025.3644237.
[54] P. Aarotale and A. Rattani, "Machine Learning-Based sEMG Signal Classification for Hand Gesture Recognition," in IEEE International Conference on Bioinformatics and Biomedicine (BIBM), 2024, doi: 10.1109/BIBM62325.2024.10822133.
[56] M. H. Zafar, E. F. Langås, S. O. G. Nyberg, and F. Sanfilippo, ''Multimodal Fusion of EEG and EMG Signals Using Self-Attention Multi-Temporal Convolutional Neural Networks for Enhanced Hand Gesture Recognition in Rehabilitation,'' in 2024 IEEE International Conference on
Omni-layer | Intelligent | Systems | (COINS), | 2024, | pp. | 1–5, | doi:
10.1109/COINS61597.2024.10622144.

[57]A. Kumar, L. Abburi, V. Aravindan, and R. Arunachallam, "Robotic Gripper With Force Feedback System," IOP Conference Series: Materials Science and Engineering, vol. 912, no. 3, p. 032049, 2020, doi: 10.1088/1757-899X/912/3/032049.

[58]J. M. Pearce, "Low-Cost Assistive Technologies for Disabled People Using Open-Source Hardware and Software: A Systematic Literature Review," IEEE Access, vol. 10, 2022, doi: 10.1109/ACCESS.2022.3221449.

[59]J. Konstantinova, A. Stilli, and K. Althoefer, ''Force and proximity fingertip sensor to enhance grasping perception,''in Proc. IEEE/RSJ Int. Conf. Intell. Robots Syst. (IROS), Hamburg, Germany, Sep. 2015, pp. 3105–3110, doi: 10.1109/IROS.2015.7353659.

[60] Y. Kanashiro and J. D. Brown, Enhanced Embedded Force Sensing in Sensorized Prosthetic Hands with Multilayered Piezoresistive Arrays,IEEE Transactions on Medical Robotics and Bionics, vol. 5, no. 4, pp. 912-922, 2023.
