AhmeBahaa/Smart-Bionic-Arm-multi-sensor-fusion/(commit log)

2026-07-10 Add initial docs and firmware files for V3 Bionic Arm
    documentation and research paper( Research not published yet ) project presentation and final coding files
2026-07-10 Moved firmware file to the correct folder
    [esp32c3_brain.ino]
